Aquaphoton-Training-25/mega-project-team-1/README.md

Review Assignment Due Date (https://classroom.github.com/a/V6TR939q)

# **the final report (technical report) is in the non technical tasks directory**
