Aquaphoton-Training-25/mega-project-team-1/Firmware/README.md

# - **You will find the mcu code in the finalmegaproject directory**   
# - **The blueetooth code is in the communication directory**
# - **The circuit trial md file have a screen shot for the first connection we made in tincker cad**
