Aquaphoton-Training-25/mega-project-team-1/Non-Technical Tasks/Daily reports/Day 8.md

# Day 8 Report
## Hardware Progression
- Fabricated the PCB. --> Soad, Ibrahim and Mazen

## Firmware Progression
- Modified the some Firmware code. --> Ibrahim and Mazen
- Tried to fix some issues with the sensors reading.  --> Mazen

## Software Progression
- Finished integrating the Stereo Vision in the GUI. --> Abdullah
- Removed some bugs and imporved performance of the App. --> Abdullah
- Integrated most of the Firmware in the GUI. --> Malak
- Started working on the Technical report. --> Malak
