Aquaphoton-Training-25/mega-project-team-1/Non-Technical Tasks/Daily reports/Day 7 Report.md

# Day 7 Report
## Hardware progression
- Finished the PCB design of the microcontroller circuit.
- Finished with the PCB design of the indicator and sensor circuit.
- Working on the printed output of the two circuits
- Working on the sticker output of the two circuits
- Working on the report
## Firmware Progression
- Adjusting microcontroller code
- Finalizing bluetooth connection file(python code).
## Software progression
- worked on the integration of the stereo vision in the gui 
- modified the gui to give it the final look
