Aquaphoton-Training-25/mega-project-team-1/Non-Technical Tasks/Daily reports/Day 6 Report.md

# Day 6 Report
## Hardware progression
- Done with the indicators and sensors schematic
- Done a schematic of the motor driver module(will be put aside until taken last decision )
- Done a general check for all schematics logic and connection (some changes have been made ) 
- Started working on the project report
## Firmware Progression
- Connected the circuit on a bread board to ensure functionality.
- Edited the arduino code.
- Started writing the python code which connects the arduino to the GUI.
## Software progression
-  Integrated the video stitching in the GUI
- Finished the camera feed and screenshot backend
- Removed bugs , increased the thread safety, and improved the app performance
