Aquaphoton-Training-25/mega-project-team-1/Firmware/circuit trial.md

# circuit trial

This screen shot is  a trial circuit but its not complete because there is no sensors and bluetooth modules in tincker cad.
