Aquaphoton-Training-25/mega-project-team-1/Non-Technical Tasks/Final Report/Final Report.pdf

# FINAL REPORT

Mazen Aboubakr
Soad Emad
Malak el Moazen
Abdallah Taman
Ibrahim Elshami

### 1. Hardware

### 1.1 Microcontroller circuit

Schematic:
The circuit was made by using the atmega328p-u microcontroller to mimic a circuit so close to the Arduino Uno on
1.ATmega328p and its connection:
1) PC6 (pin 1) I/O pin used as the RESET pin connected to:
- hardware reset, When the voltage on this pin drops to a low level (typically below a certain threshold), the microcontroller resets restarting its program execution.
- Pull-up resistance (R1) is connected between the RESET pin (PC6) and the +5V, This resistor keeps the pin at a high voltage level when no reset signal is applied, preventing accidental resets, and the electrolytic polarized capacitor connected with the reset button 7805 to minimize debouncing problems
2) PD0 (pin 2) is connected to the pin 0 in an 8-pin header pack
3) PD1 (pin 3) is connected to the pin 1 in an 8-pin header pack
4) PD2 (pin 4) is connected to the pin 2 in an 8-pin header pack
5) PD3 (pin 5) is connected to the pin 3 in an 8-pin header pack
6) PD4 (pin 6) is connected to the pin 4 in an 8-pin header pack
7) PD5 (pin 11) is connected to the pin 5 in an 8-pin header pack
8) PD6 (pin 12) is connected to the pin 6 in an 8-pin header pack
9) PD7 (pin 13) is connected to the pin 7 in an 8-pin header pack
- 2) to 9) all have the same use in our schematic which is a general-purpose digital input/output pin. It can be configured as an input or output through software, and its state can be read or set using the appropriate I/O registers.
10) VCC (pin 7) connected directly to the +5v output of the linear regulator 7805 to power the whole microcontroller circuit
11) GND (pin 8,22) connected directly to the common ground between the battery and regulator
12) PB6 (pin 9) is connected to
- One side from the crystal oscillator provides the clock for the microcontroller, PB6 serves as the input for the oscillator signal
- A ceramic capacitor(C4) to stabilize the crystal's oscillation frequency and form a resonant circuit with the crystal. This resonance ensures that the oscillation amplitude is consistent

13) PB7 (pin 10) is connected to
- The other side from the crystal oscillator provides the clock for the microcontroller, PB6 serves as the output for the oscillator signal
- A ceramic capacitor(C5) to stabilize the crystal's oscillation frequency and form a resonant circuit with the crystal. This resonance ensures that the oscillation amplitude is consistent
14) PB0 (pin 14) is connected to the pin 8 in a 10-pin header pack
15) PB1 (pin 15) is connected to the pin 9 in a 10-pin header pack
16) PB2 (pin 16) is connected to the pin 10 in a 10-pin header pack
17) PB3 (pin 17) is connected to the pin 11 in a 10-pin header pack
18) PB4 (pin 18) is connected to the pin 12 in a 10-pin header pack
19) PB5 (pin 19) is connected to
- the pin 13 in a 10-pin header pack
- a LED (D1) with its limiting resistance (R2) to test the functionality of the microcontroller in the circuit (BUILT-IN LED)
- 2) to 9) all have the same use in our schematic which is working as an 8-bit bi-directional I/O port with internal pull-up resistors (selected for each bit). It can be configured as an input or output through software, and its state can be read or set using the appropriate I/O registers
20) AVCC (pin 20) is sensitive to power fluctuations which is crucial for providing power to the analog-to-digital converter (ADC) and some of the analog circuitry
- to the +5v output of the linear regulator 7805 ensures a stable supply.
- a polarized electrolytic capacitor(C1) which is connected directly to GND which is essential for filtering out any noise or voltage fluctuations in the power supply
21) AREF (pin21) is used to provide a reference voltage for the analog-to-digital converter (ADC), the technique used in our project to power it is to connect it with an external +5 volt by using a jumper from the Arduino UNO
22) PC0 (pin 23) is connected to the pin A0 in a 6-pin header pack
23) PC1 (pin 24) is connected to the pin A1 in a 6-pin header pack
24) PC2 (pin 25) is connected to the pin A2 in a 6-pin header pack
25) PC3 (pin 26) is connected to the pin A3 in a 6-pin header pack
26) PC4 (pin 27) is connected to
- the pin A4 in a 6-pin header pack
- the pin SDA in a 10-pin header pack to serve as the SDA line for I²C communication
27) PC5 (pin 28) is connected to
- the pin A5 in a 6-pin header pack
- the pin SCL in a 10-pin header pack which is used for clocking data on the I²C bus. It works in conjunction with the SDA pin (PC4)

- 22) to 27) all have the same use in our schematic which is a 7-bit bi-directional ANALOG I/O port with internal pull-up resistors. It can be configured as an input or output through software, and its state can be read or set using the appropriate I/O registers

### 2. linear regulator 7805:

- powering the whole circuit of the microcontroller and the other external components that will be attached
- protection for the microcontroller as it stables the high voltage coming from the power supply, battery, and adaptor to a +5 voltage which is the maximum safest option for atmega328-p

### 3. battery terminal: to attach the battery or the adaptor to it

### 4. pin headers: To interface and connect with external components

5. ceramic capacitors: which are placed close to GND or VCC to work as decoupling capacitors to:
- filter out high-frequency noise from the power supply, which could otherwise interfere with the proper operation of the circuit
- stabilize the voltage supply by compensating for sudden drops or spikes in power consumption
- reduce electromagnetic interference (EMI) in the circuit by providing a short path to ground for high-frequency signals

### 6. electrolytic polarized capacitors:

- C1: filtering out any noise or voltage fluctuations in the power supply
- C2: minimize debouncing problem coming from the push button

### 7. crystal oscillator:

- generates a stable clock signal that dictates the speed at which the microcontroller executes instructions. This clock frequency directly affects the timing of all operations, including loops, delays, and communication protocols.

### 8. led: to indicate that the circuit is working

### 9. resistance:

- R1: pullup resistance to keep the point at high voltage (not floating)
- R2: limiting current resistance to protect the diode

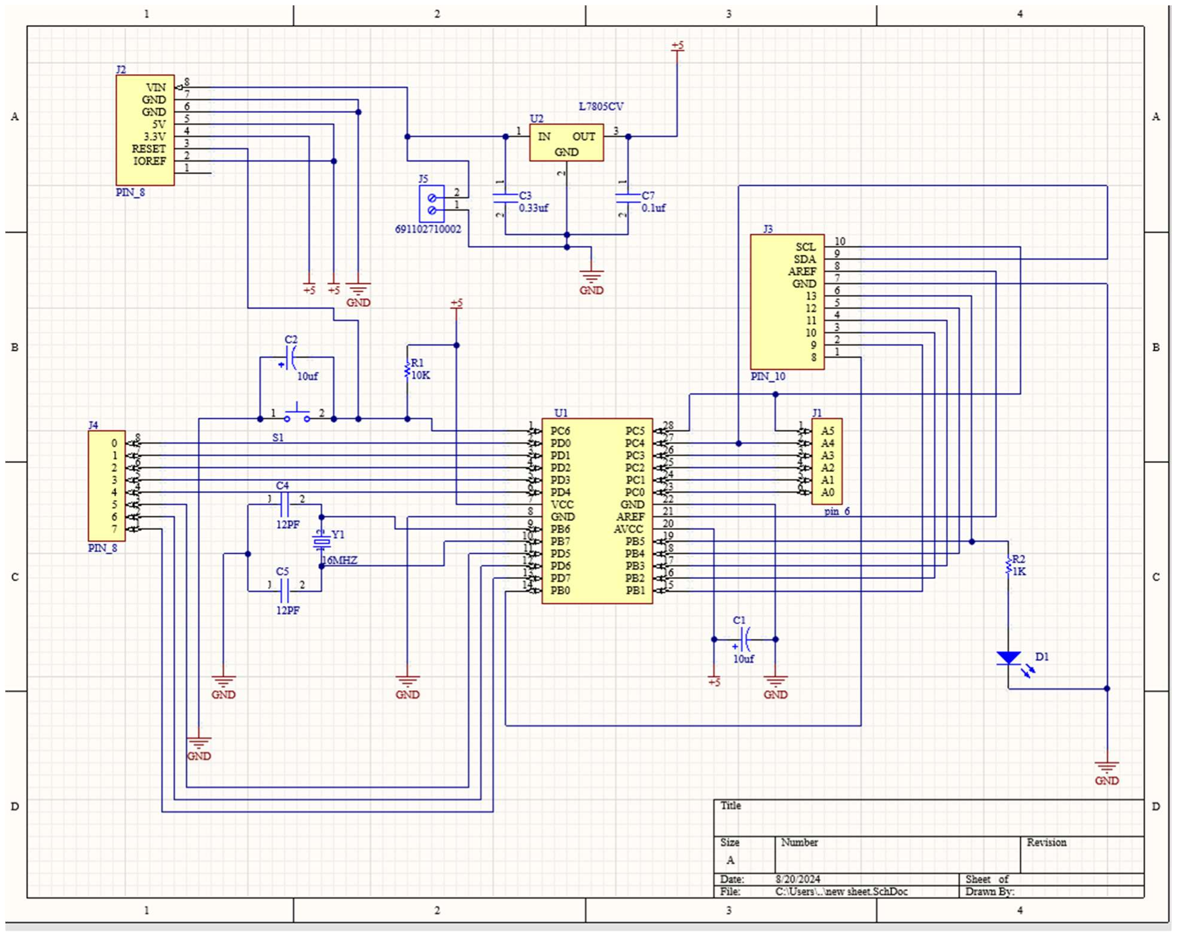
[picture p1: figure]

### 2. PCB layout and design:

The components were placed according to the logic, standards, rules, routing ability
- Battery terminal and regulator placed close together on the high left of the PCB board
- Pin-headers and other components were placed according to the shortest, most untangled path with the atmega328p
Number of layers: one layer (top)
Minimum clearance: 0.5mm
Average clearance: 0.5mm
Routing width (max, min, preferred): 0.8mm
Routing: was done automatically with manual checks and edits Design rules: was checked and made sure all are logical

Dimensions: 12.2cm *17.8cm

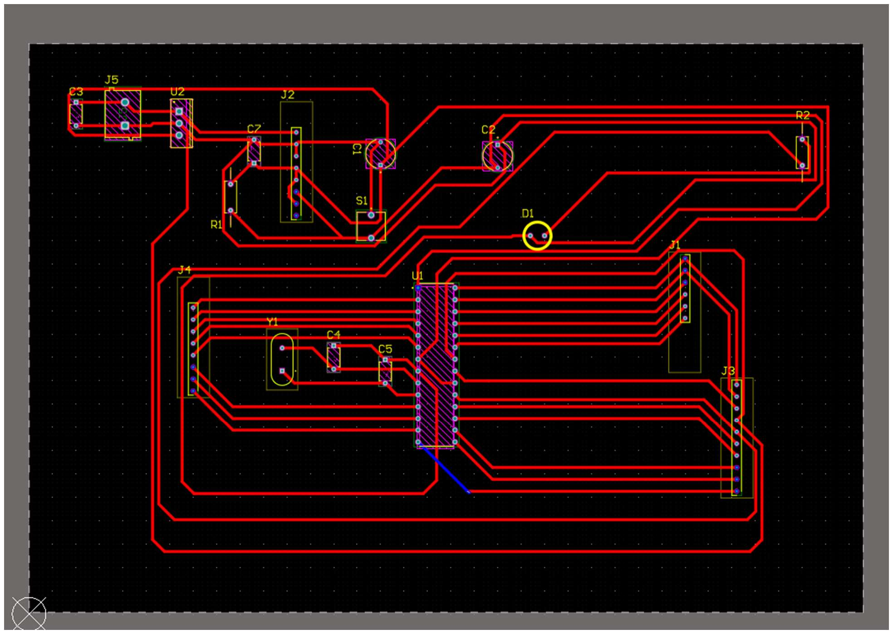
[picture p2: figure]

### 3. symbols and footprint:

According to the datasheet and real-life measured components:
- Some were made manually and
- others were downloaded and imported from specific electronic websites (mouser, snapeda, etc), and then the required edits were made upon them

Indicators and sensors circuit
1.schematic:

### 1. voltage divider:

were made internally in the circuit (not as a separate module) by using two resistances R4 and R5, the values for resistances allow a maximum voltage read of 28.5
R4 is a 1k ohm resistance attached to:
- Node common between measured ground and Arduino ground
- The sensing point which is a pin (I-sens) that would be connected to the analog pin on the Arduino
R5 is a 4.7k ohm resistance attached to:
- Sensing point
- A pin that will be connected to the measured voltage

### 2. LEDs (D1, D3, D4):

Indicators for different aspects of the circuit

### 3. RGB LED(D1):

Indicator for the speed, where each color pin is connected with a pin from a 10-pin header pack that will be connected to the pin-headers of the microcontroller, GND will be connected to the GND from the microcontroller circuit

### 4. Resistances (except the voltage divider ones):

They are current limiting resistance to protect the indicator LEDs, their values were put according to the datasheet

### 5. Linear regulator 7805:

Ensure that the voltage coming from the mc or going to it is a +5v

### 6. Ceramic capacitors (C1, C2):

Decoupling capacitor for filtration

### 7. Pin-headers (J1, J2):

### 2 sets of 10-pack pin headers are used for

- Connection for interfacing with microcontroller pins
- Additional ground and power pins for other external components

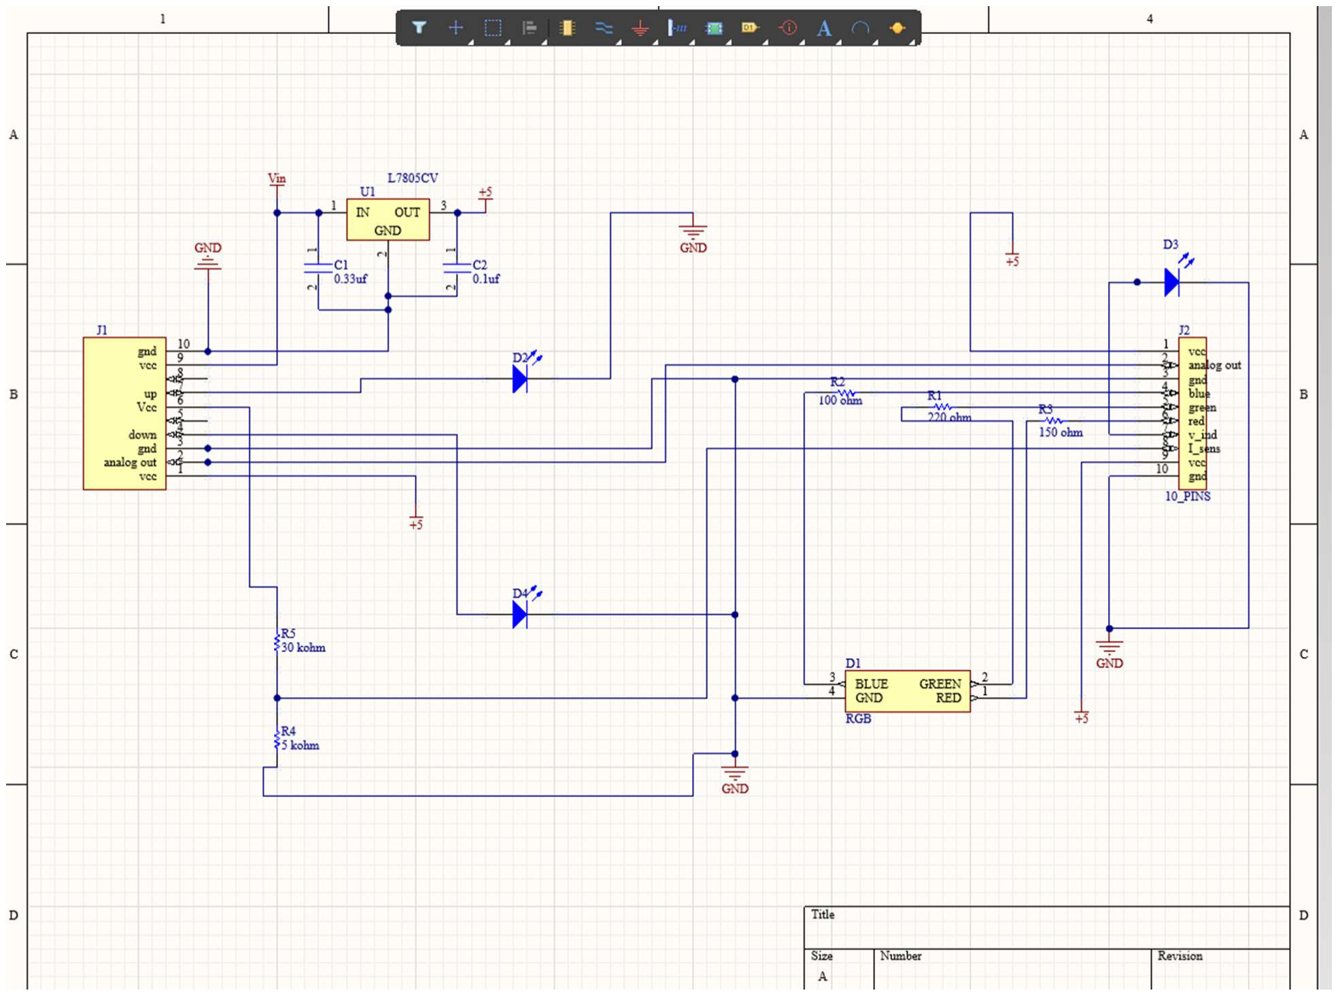
[picture p3: figure]

### 2. PCB layout and design:

The components were placed according to the logic, standards, rules, routing ability
- Battery terminal and regulator placed close together on the high left of the PCB board
- Pin-headers and other components were placed according to the shortest, most untangled paths
Number of layers: one layer (top)
Minimum clearance: 0.7mm
Average clearance: 0.7mm
Routing width (max, min, preferred): 0.8mm
Routing: was done automatically with manual checks and edits Design rules: was checked and made sure all are logical Dimensions: 8.5cm *6.5cm

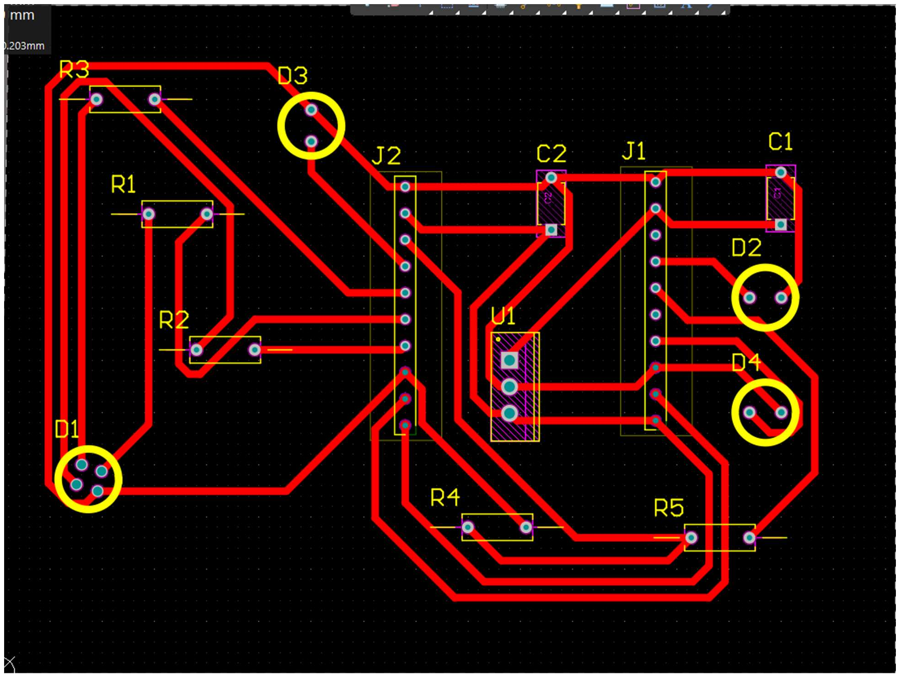
[picture p4: figure]

### 3. symbols and footprint:

According to the datasheet and real-life measured components:
- Some were made manually
- others were downloaded and imported from specific electronic websites (mouser, snapeda, etc), and then the required edits were made upon them

### 2. Firmware 2.1 Arduino code

The code starts with declaring all constant values needed using #define to reduce usage of memory as possible and to hold the pin numbers of each component, the constants are distributed as following 3 constants for each motor 2 if them to specify the motor’s direction and the third constant to specify its speed, 2 constants for the trigger and echo pin of the ultrasonic sensor ,3 constants for the RGB led one for each color and two constants for the current and voltage sensors.

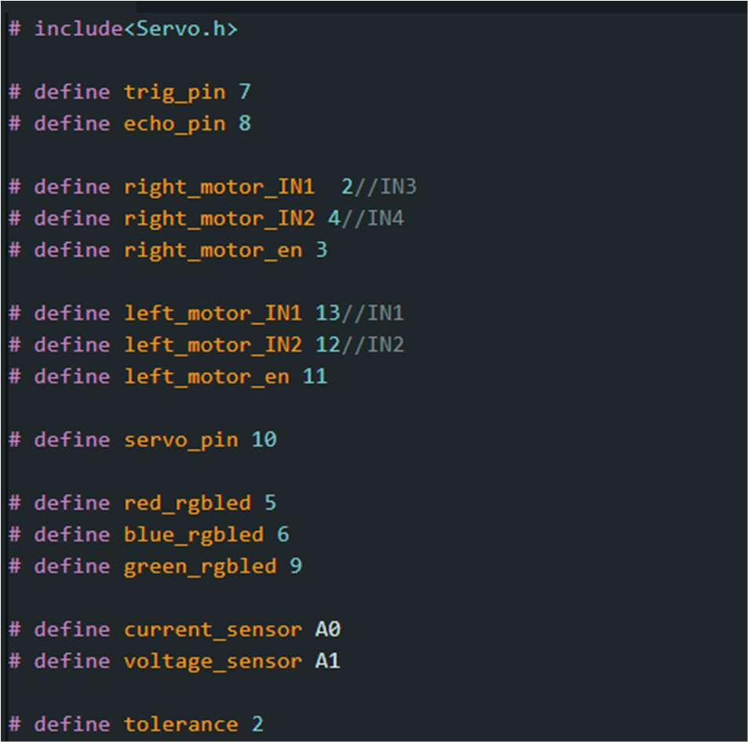
[picture p5: figure]

The code then proceeds to declaring all variables with the needed datatypes.

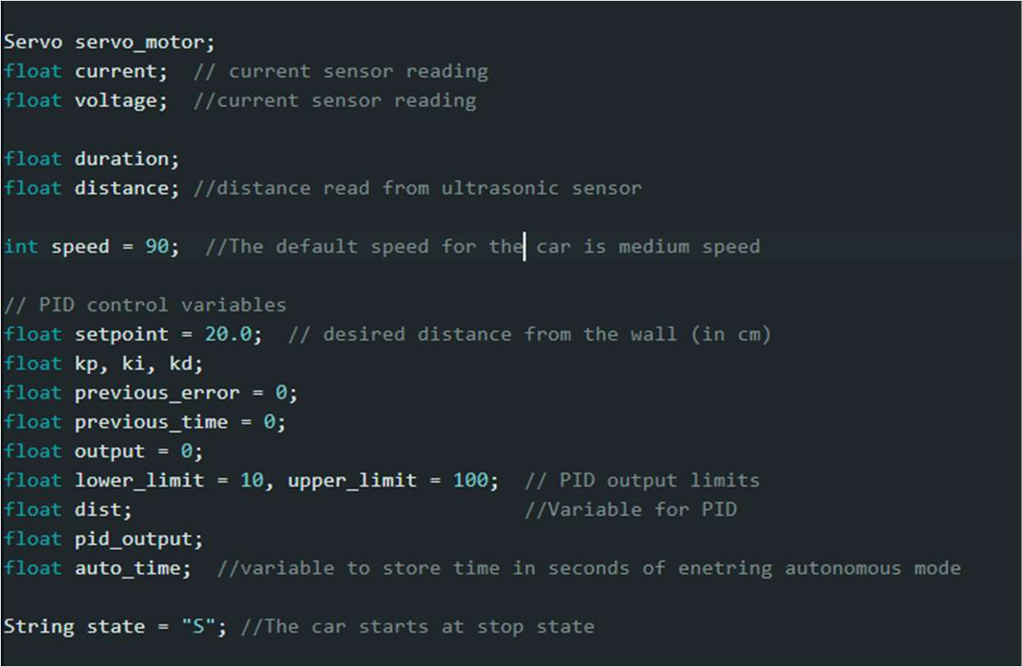
[picture p6: figure]

In the setup all commands that need to be made once are called as assigning INPUT/OUTPUT modes for each pin to serve its purpose and starting Serial connection to allow communication between microcontroller and the GUI user

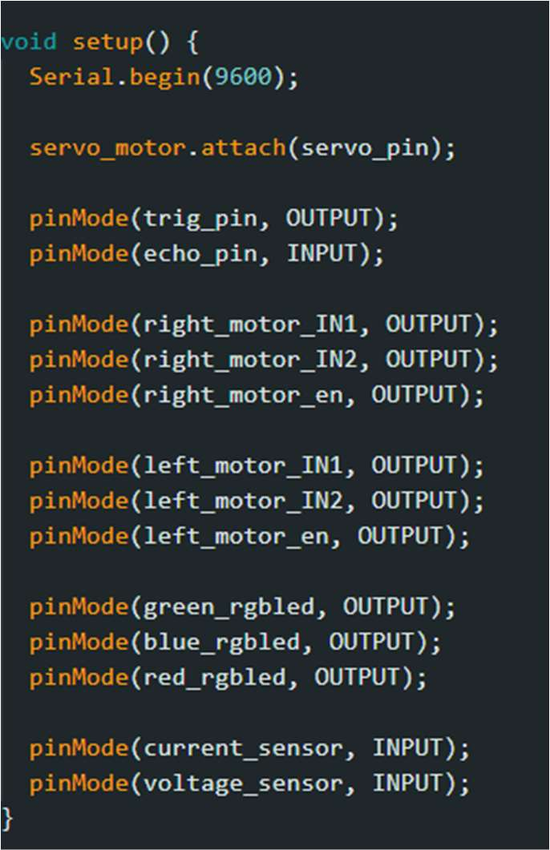
[picture p7: figure]

In order to understand the role of the loop function, we should first know other fundamental functions work.
The process_command function which is called
each time any commands are given by the user,
the process _command function uses a series of if-else statements to map the commands received to the corresponding functions to be called.

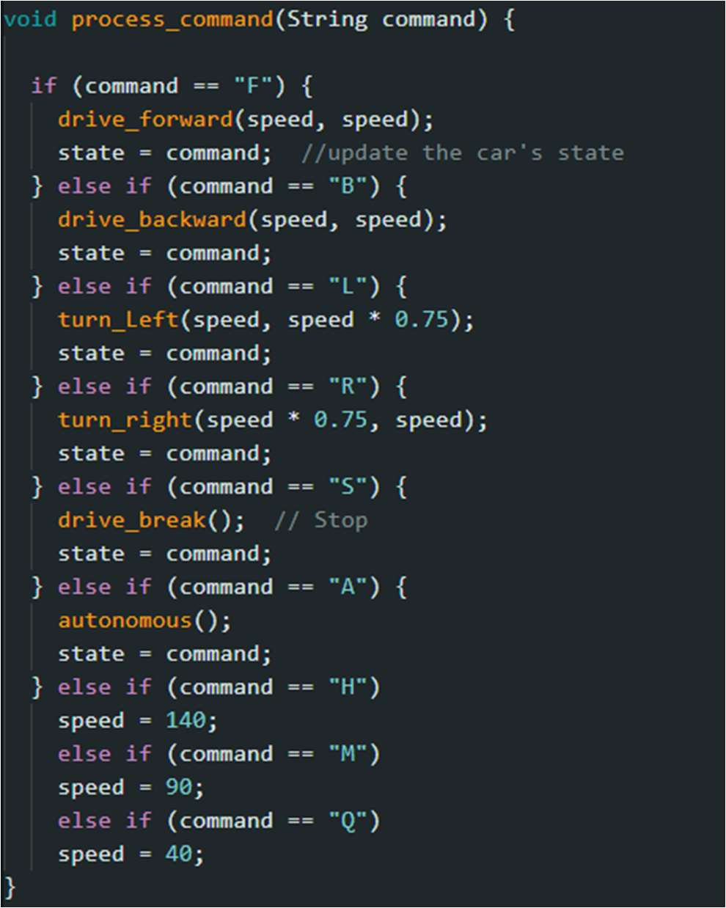
[picture p8: figure]

The read distance function gets the ultrasonic reading which ranges from 2cm to 400 cm when called, this function is used later in find_wall function which is used to find the nearest wall and its distance in autonomus mode by using a servo to mount the ultrasonic sensor, the servo is set to be on the a side, then the distance to the wall is received then the servo moves the sensor to the other side and the distance to the second wall is stored, then the two reading are compared and the servo rotates to the nearest wall side and the car moves parallel to it

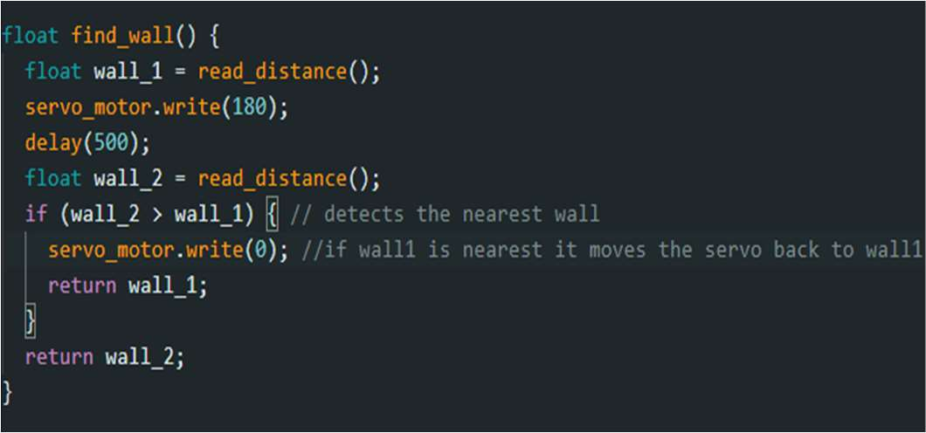
[picture p9: figure]
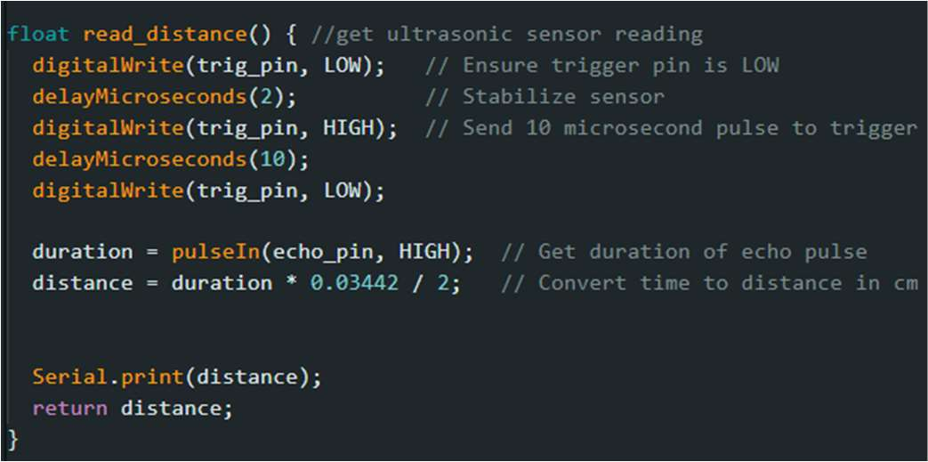
[picture p10: figure]

The read_current function reads the voltage on the current_sensor pin and applies it to a reversed equation to calculate the current reading. The equation: current= (voltage-2.5)/0.185 according to the ACS712 5A.
The read_voltage function reads the voltage on the voltage_sensor pin which is the voltage on a 1 kilo ohm which is connected in series to a 4.7 kilo ohm so by applying a reverse voltage divider we can get a voltage range of 0-28.5 volts, the voltage is found by applying the following equation Voltage = (1k ohm resistance voltage*(1k ohm+4.7k ohm)/1k ohm.

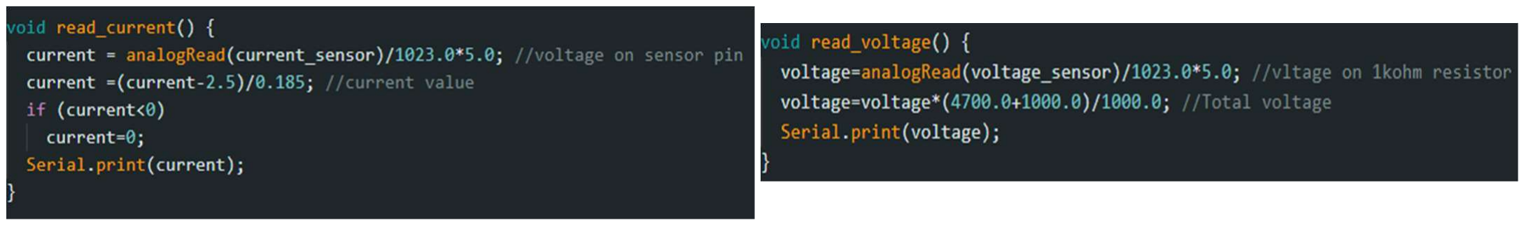
[picture p11: figure]

The send_readings function calls the 3 sensors functions ,read_voltage(), read_current(), read_distance(), sends their readings divided by a colon and then send the car state and prints a newline character ‘\n’ to ensure data has a consistent format to be easily received on the user’s end.

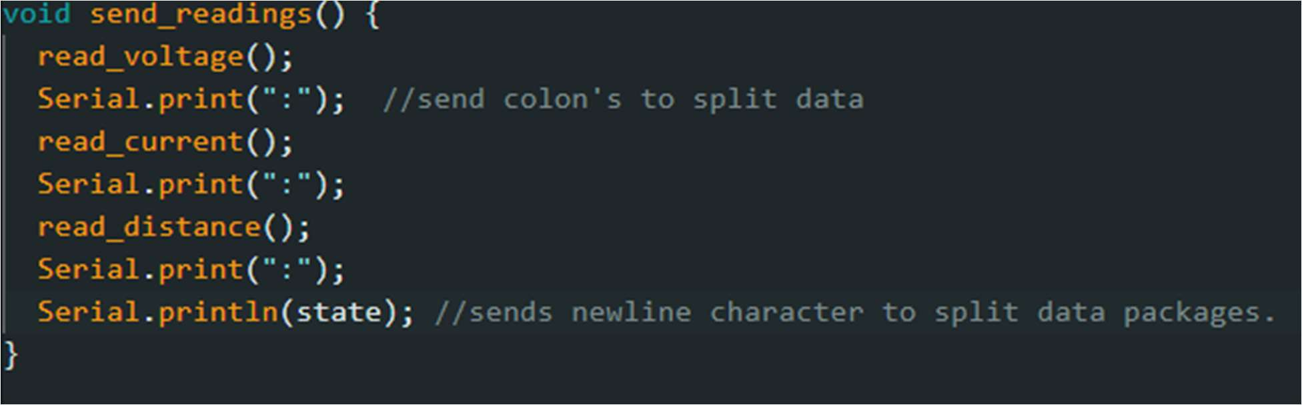
[picture p12: figure]
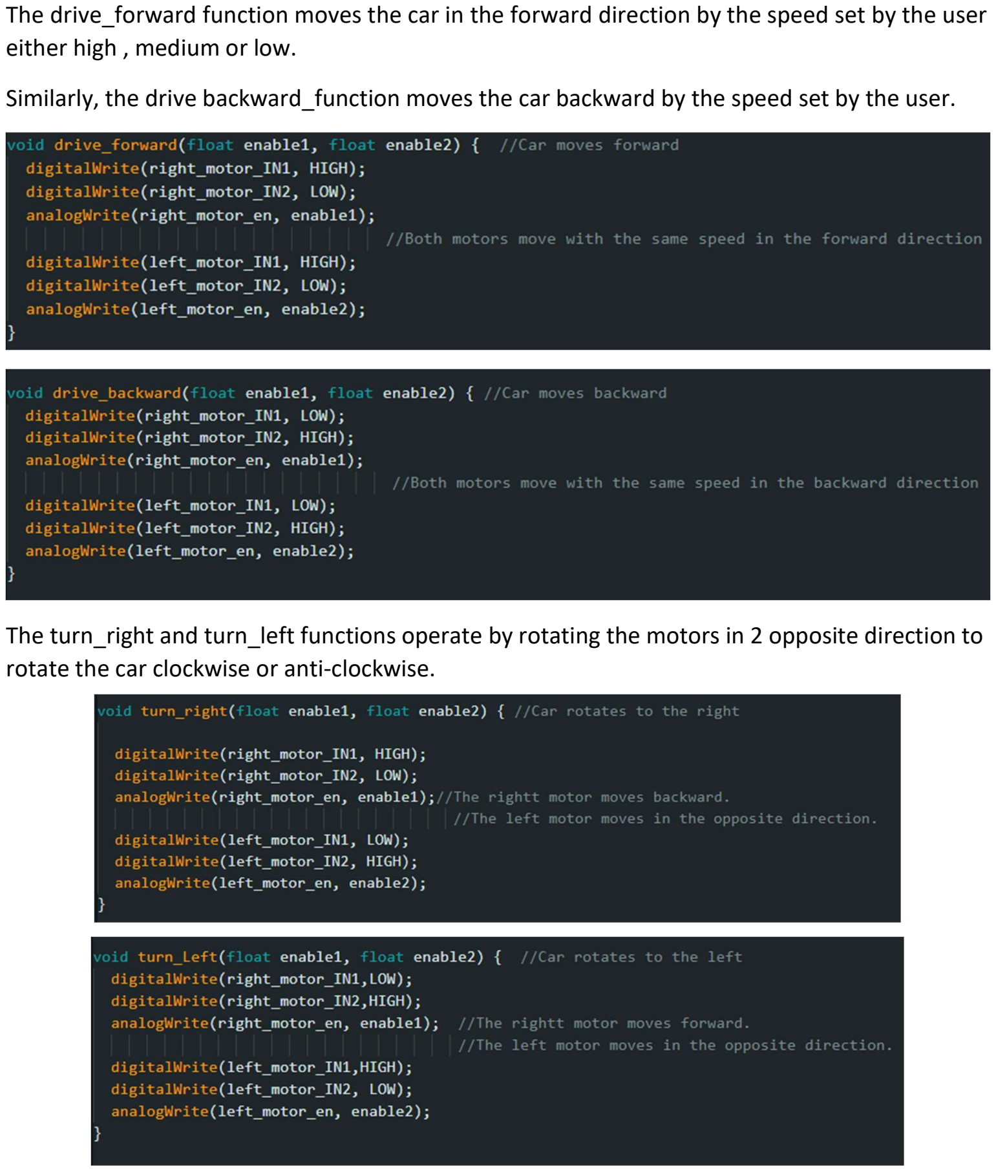
[picture p13: page 13]

The drive_forward function moves the car in the forward direction by the speed set by the user either high , medium or low.
Similarly, the drive backward_function moves the car backward by the speed set by the user.

The turn_right and turn_left functions operate by rotating the motors in 2 opposite direction to rotate the car clockwise or anti-clockwise.

The last motion related function is the drive_break function which stops rotation of the motors, it is also used to exit autonomous mode and enter manual mode.

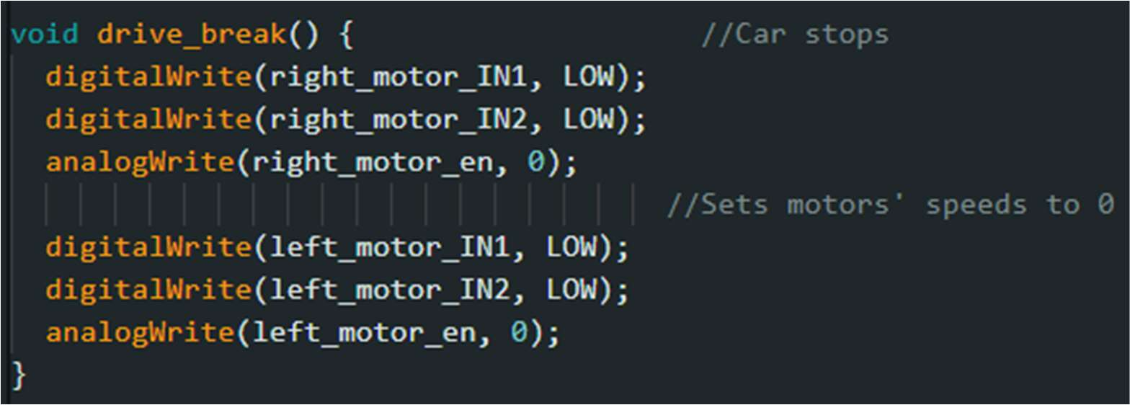
[picture p14: figure]

The compute_output function is for the calculation of the PID equation that takes the feedback from the ultrasonic sensor to calculate the error between the desired distance and the current distance from the wall then it calculate the PID equation that consist of three terms:

### 1. proportional term: the multiply of proportional gain (Kp)and the error

2. integral term: the multiply of integral gain(Ki) , error and the delta time.
3. derivative term: division of error to the change in time then multiply to the derivative gain (Kd).
After it calculates the output It calls the map_to_limits_function to set the limits as we explained in the documentation of the map_to_limits_function, then it returns the last output.

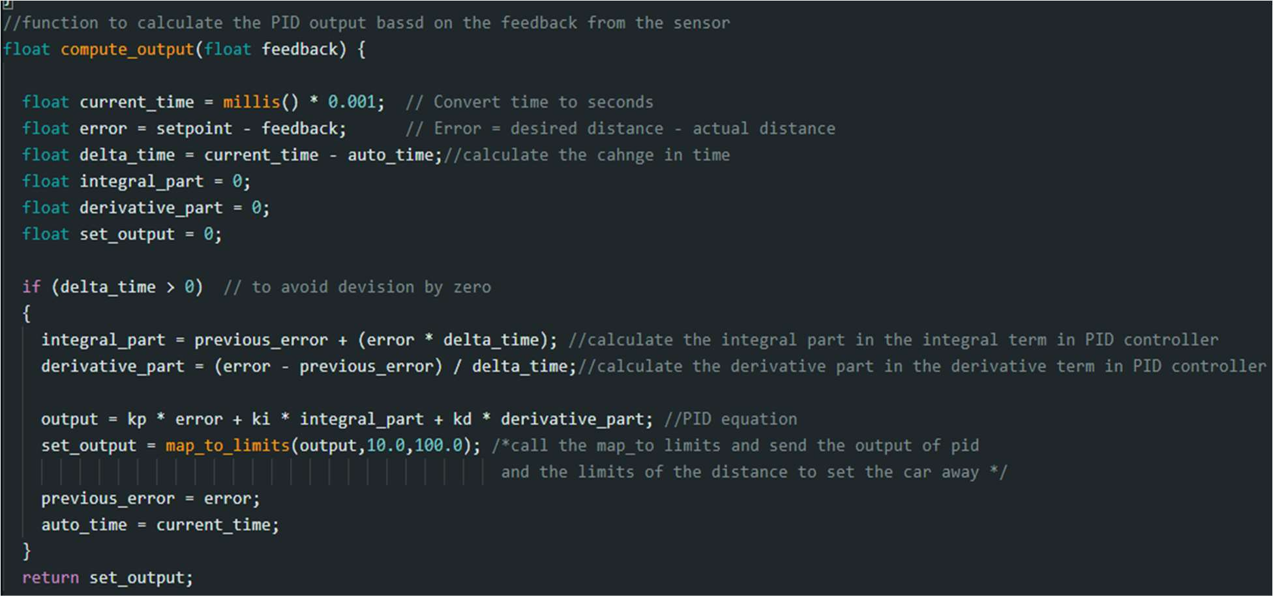
[picture p15: figure]

The map_to_limits function is used to set limits to the output of the PID controller to ensure that it is in the range that we want and it takes three variables, the lower limit and the upper limit for the range and the value of the output of the PID

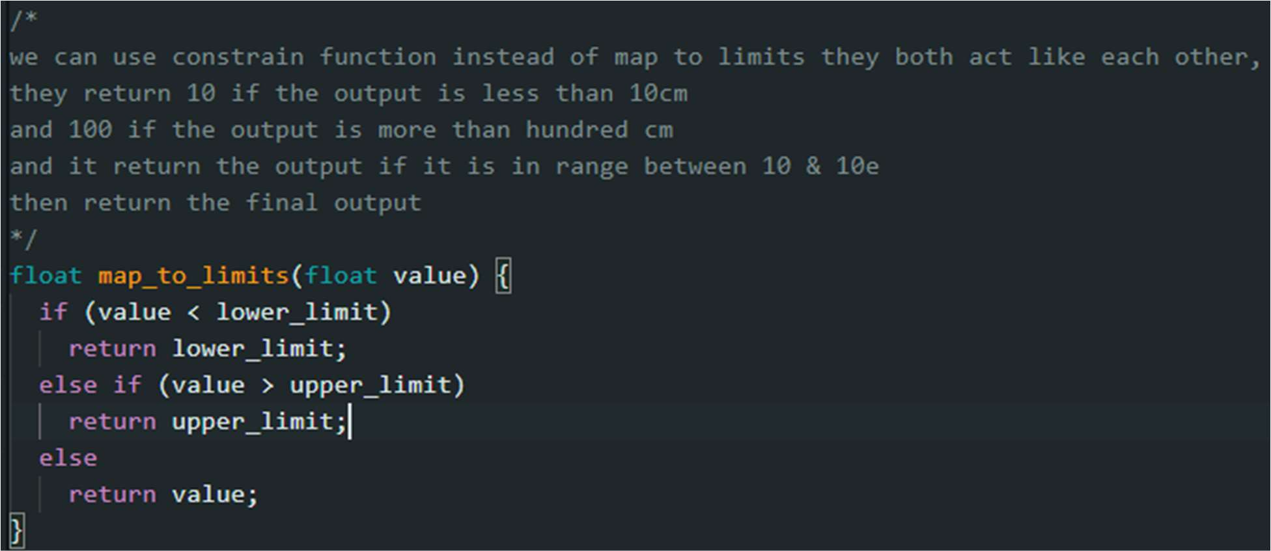
[picture p16: figure]

The control_motors function is used to get the output of the PId then use it to control the sped of the two motors to turn right or left, to make the car move parallel to the wall from a fixed distance and the if condition in it is to detect if the difference between the desired distance and the current distance is less than the tolerance of the sensor that is set to 2 as we try to read the distance from the ultrasonic sensor in tinckercad and we found that after we adjust the speed of sound to be 0.3442 and we reached a small error in the read . Then it sees if the difference is less than the tolerance it will make the motor move forward and parallel to the wall If not it will make the car turn right or left to reach the desired distance.

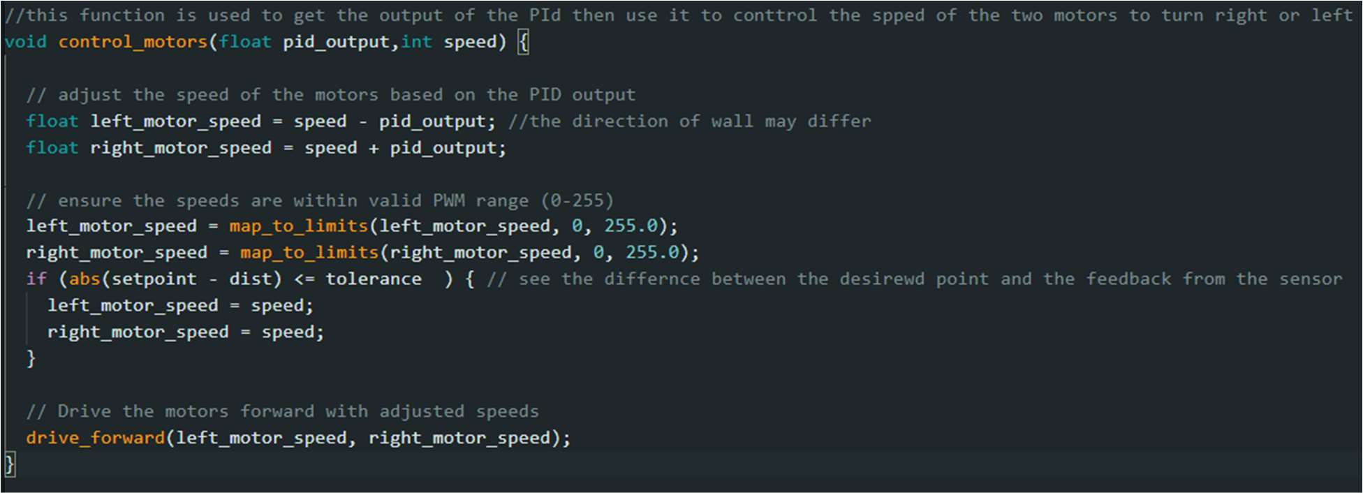
[picture p17: figure]

The autonomous function function is used when we click the autonomous mode in the GUI, it first sets the servo direction to the nearest wall using find_wall function and returns the distance between this wall and the car then it will see if it gets the Stop command it will break and exit the function if not it will compute the feedback and control the motors to move parallel to the wall.

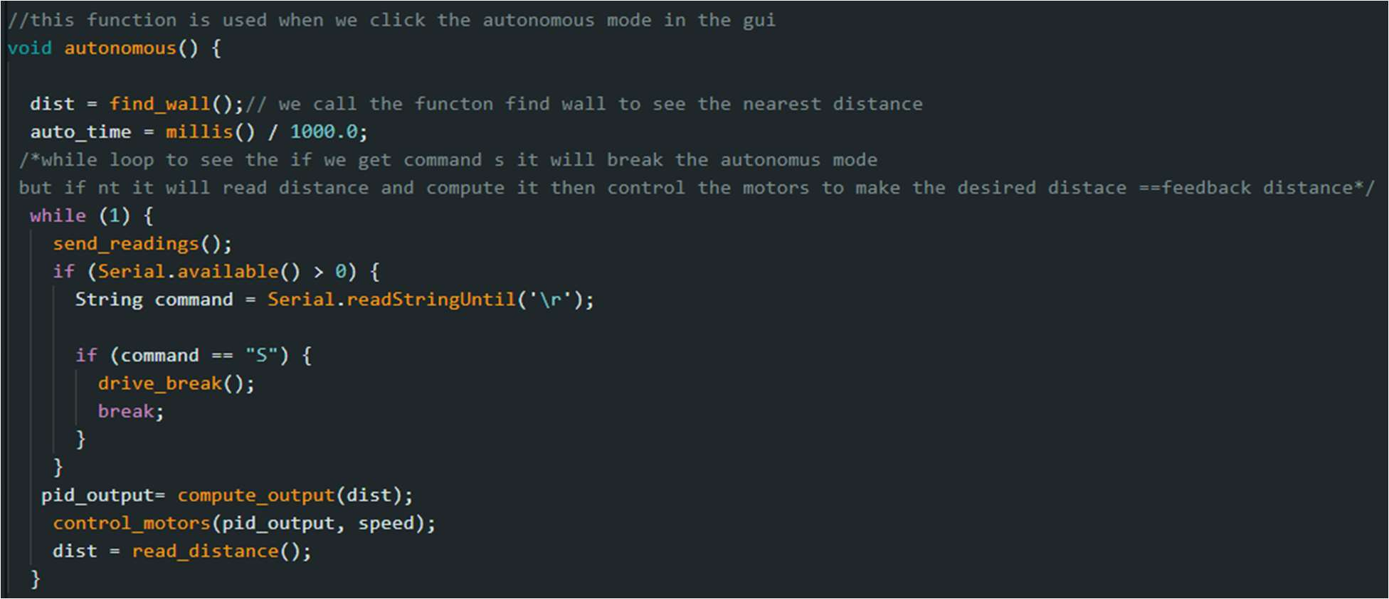
[picture p18: figure]

After understanding the fundamental functions we can understand the loop function role which is the key to switching the car’s modes and states were the user’s commands are read in it and processed using process_command function by calling the required functions and the loop function ends by send_readings function to ensure updated data are always available for the user.

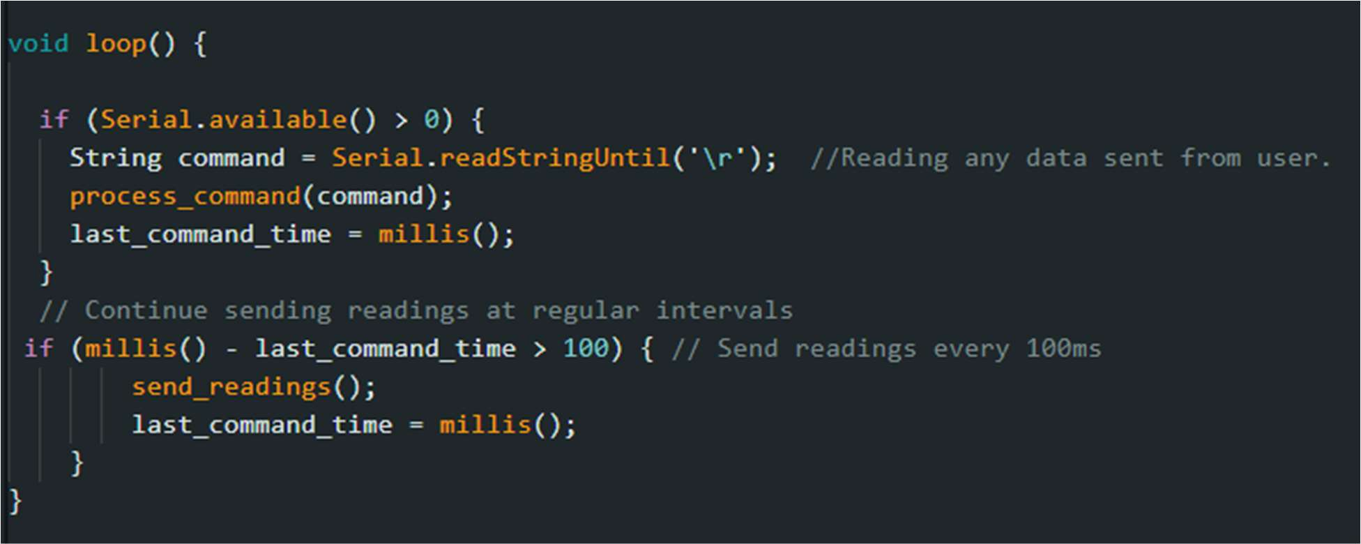
[picture p19: figure]

### 2.1 Python code

The python uses Pyserial library to allow communication between the microcontroller and the GIU over Bluetooth.
The code begins with improting the Pyserial library and time library which is used to add delays in the code to allow initialization of connection.
The first event that occurs is creating an instance of Serial class giving it the necessary arguments which are the COM port of the Bluetooth and the baudrate which is the number of bytes sent per second to be compatible with the Bluetooth module.

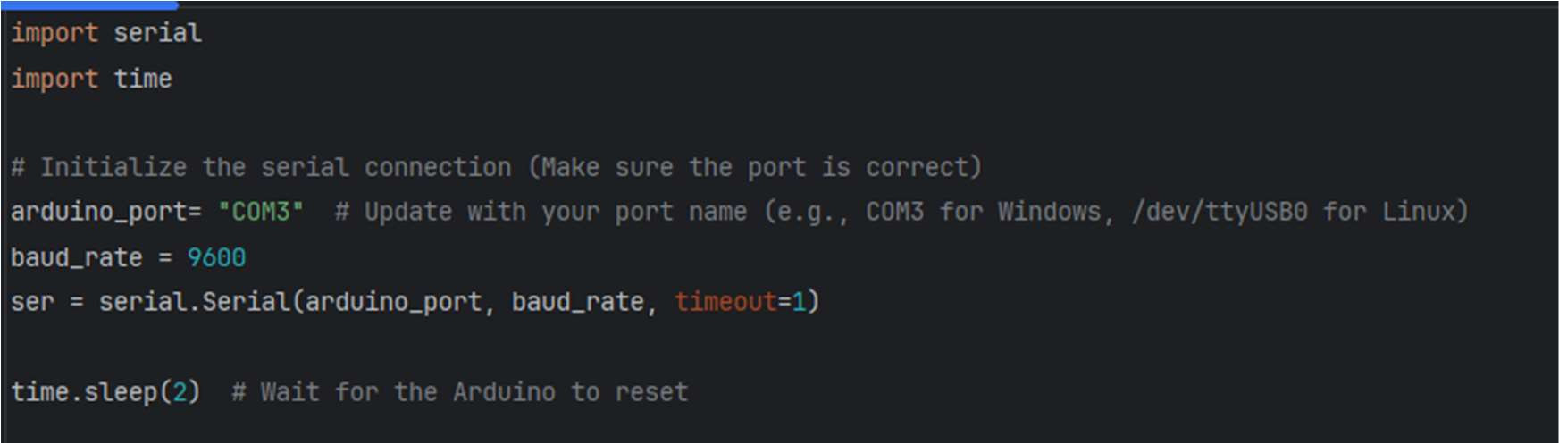
[picture p20: figure]

The code contains 2 main functions which are send_command and the receive_command.
The send_command function receives one argument which is the command letter and and adds a carriage return character which is used to prevent conflict of commands then decodes the command and transmits it

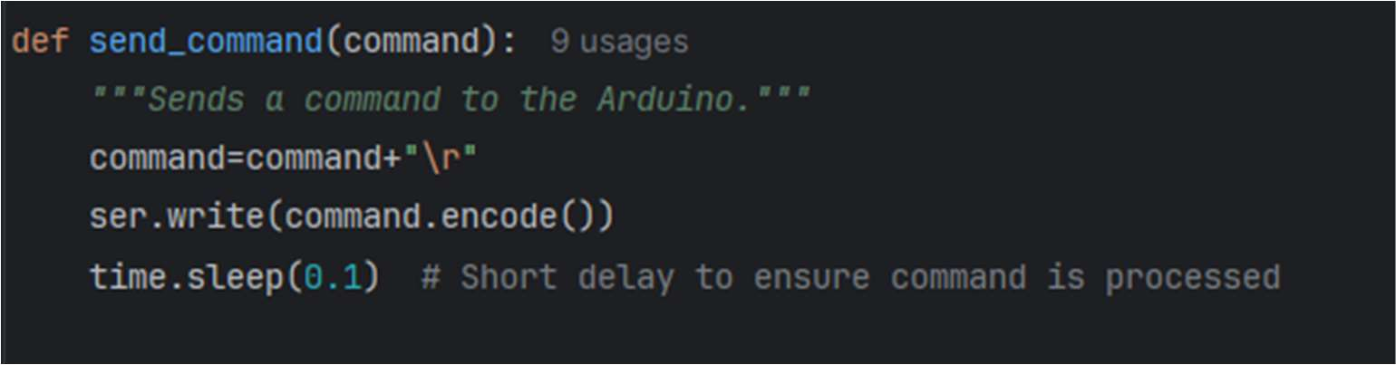
[picture p21: figure]

The receive_data function is used to check if any reading are sent from the mc and unpacks the data and adds each reading to its corresponding variable

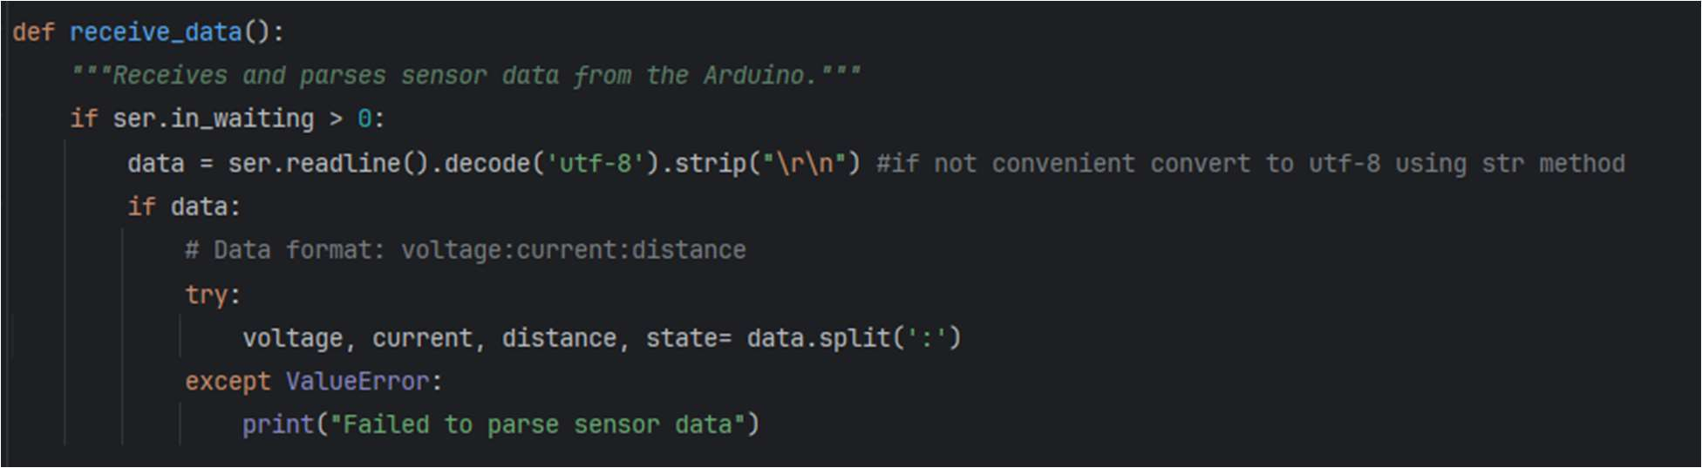
[picture p22: figure]

All other functions are used to provide the unique command character for the needed command

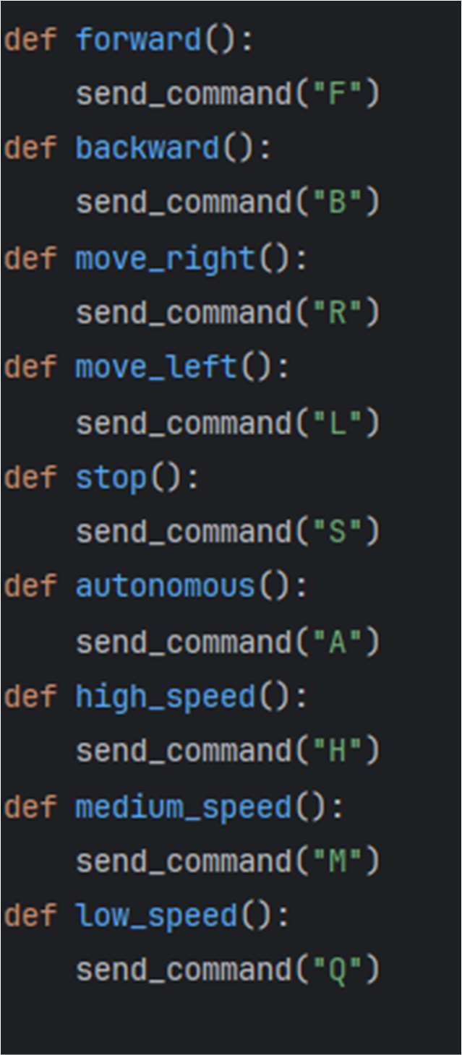
[picture p23: figure]

It is decided not to use this python file (car_control.py) which is uploaded to the repository to avoid an error that prevents access to the mc COM port instead all function are written inside the main GUI file.

3.SOFTWARE

### Computer vision

1-video stitching
The video stitching system integrates video processing and graphical user interface (GUI) components to perform real-time video stitching of left and right video feeds.
We use :
PyQt6 GUI: For user interaction, allowing users to select video files and control stitching operations.
OpenCV: For video processing, including reading video files, stitching frames, and saving the output.
Multithreading: To handle video processing
Algorithm :
- Input: Two video files (left and right views).
- Process: Stitches frames from both videos into a single panoramic view.
- Output: A stitched video file

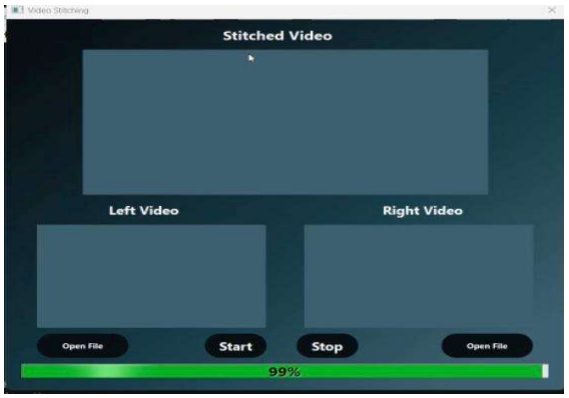
[picture p24: figure]

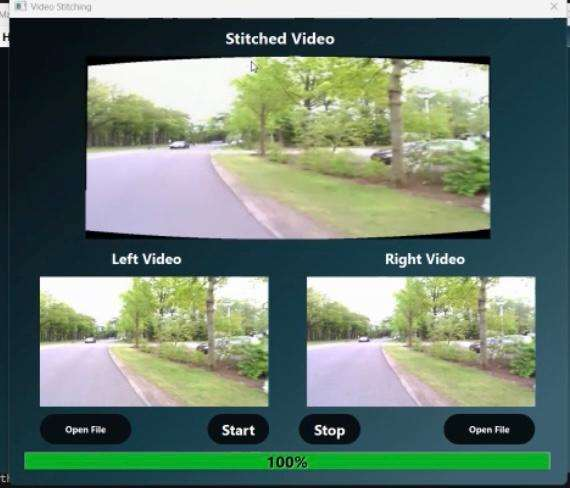
[picture p25: figure]
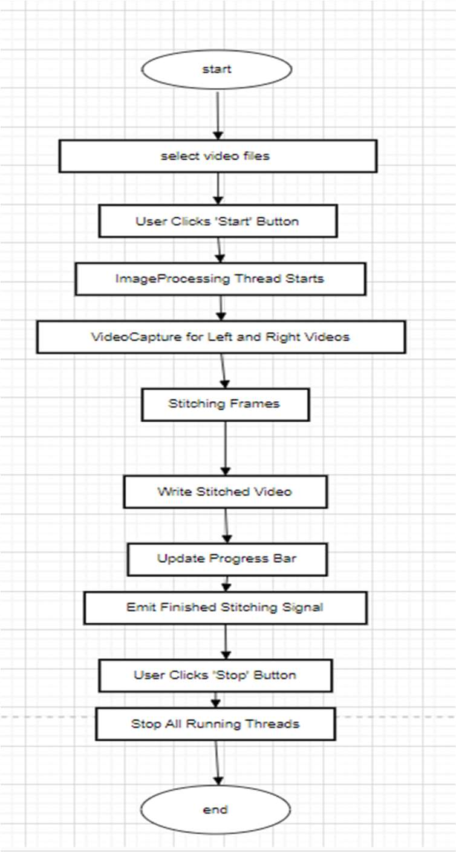
[picture p26: figure]

2-stereo vision
Stereo vision is a technique for inferring the 3D structure of a scene from two images taken from slightly different viewpoints.
We Use:
the SIFT (Scale-Invariant Feature Transform) algorithm to detect keypoints and compute descriptors in both images.We Match features between the two images using the BFMatcher (Brute Force Matcher) with the L2 norm, Filter out outlier matches using the mask returned by the RANSAC process. Initialize the StereoSGBM (Semi-Global Block Matching) algorithm with appropriate parameters, including the number of disparities, block size, and uniqueness ratio. Compute the disparity map using the rectified images. The disparity map represents the pixel difference between corresponding points in the two images. Algorithm :
- Input: Two image files (left and right views), width ,height ,baseline and camera matrices
- Process: Plotting the epipolar lines on both images along with feature points,save the disparity as a gray scale and color image using heat map conversion and save the depth image as a gray scale and color image using heat map conversion.
- Output: in GUI the image will appear and you can know the distance between any 2 points

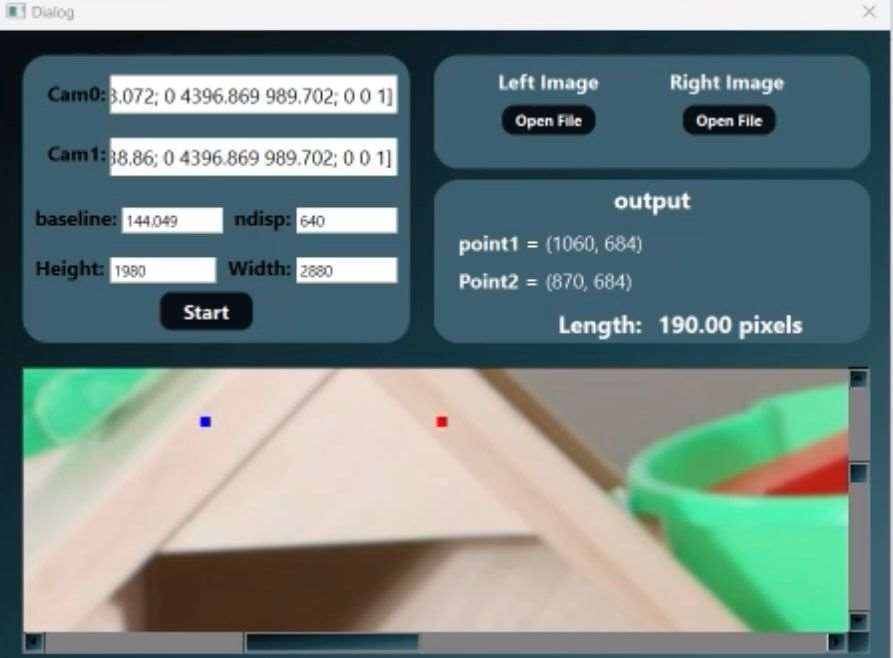
[picture p27: figure]

Flow chart:

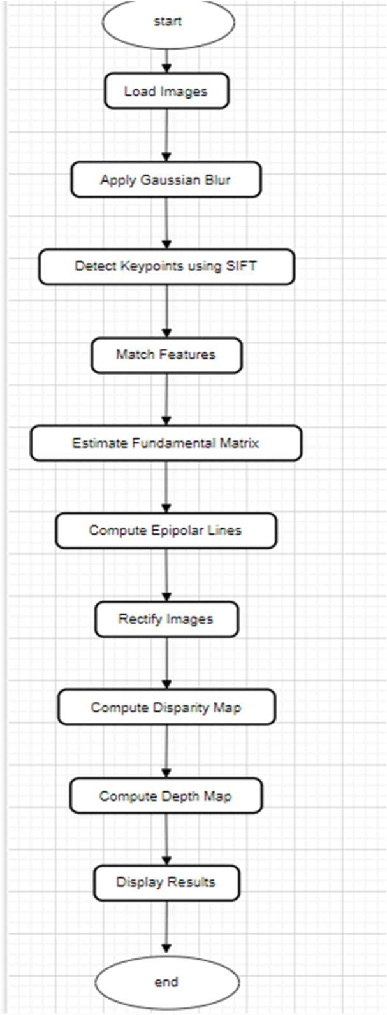
[picture p28: figure]

### GUI:

Mainwindow:
We use tab widget in each window, The GUI features a central QTabWidget with three tabs: Home , Control and camera. Each tab contains styled buttons and labels arranged in frames with rounded corners. The color scheme involves shades of blue with white text.
Home Tab :
includes buttons for "Video Stitching" and "Stereo Vision," and displays the team logo.

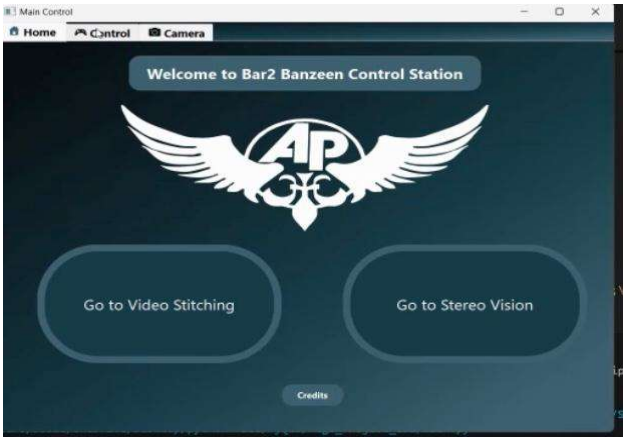
[picture p29: figure]

Control tab :
1.Mode Selection
Autonomous and Manual Mode: allowing the user to choose between autonomous operation (where the system operates independently) and manual operation (where the user has direct control).

### 2. Speed Control

- High, Medium, Low Speed Settings: There are three buttons which likely control the speed of the system. The user can select one of these buttons to adjust the operating speed.

### 3. Controller Selection

- Keyboard and GUI Options: There are two buttons labeled "Keyboard" and "GUI." These allow the user to choose the control method

### 4. Movement Controls

- Directional Control Buttons: There are four directional buttons arranged in a circular pattern, which are used to control the movement of the vehicle . These include buttons for moving forward, backward, left, and right.

### 5. Additional Indicators and Information

- Indicators Panel: This section provides information about various parameters such as voltage, current, speed, mode, distance, direction, connection status, and the type of controller in use. It’s designed to keep the user informed about the status and performance of the system.
- Stop Button: A prominent red button labeled "Stop" is also present to stop the vehicle

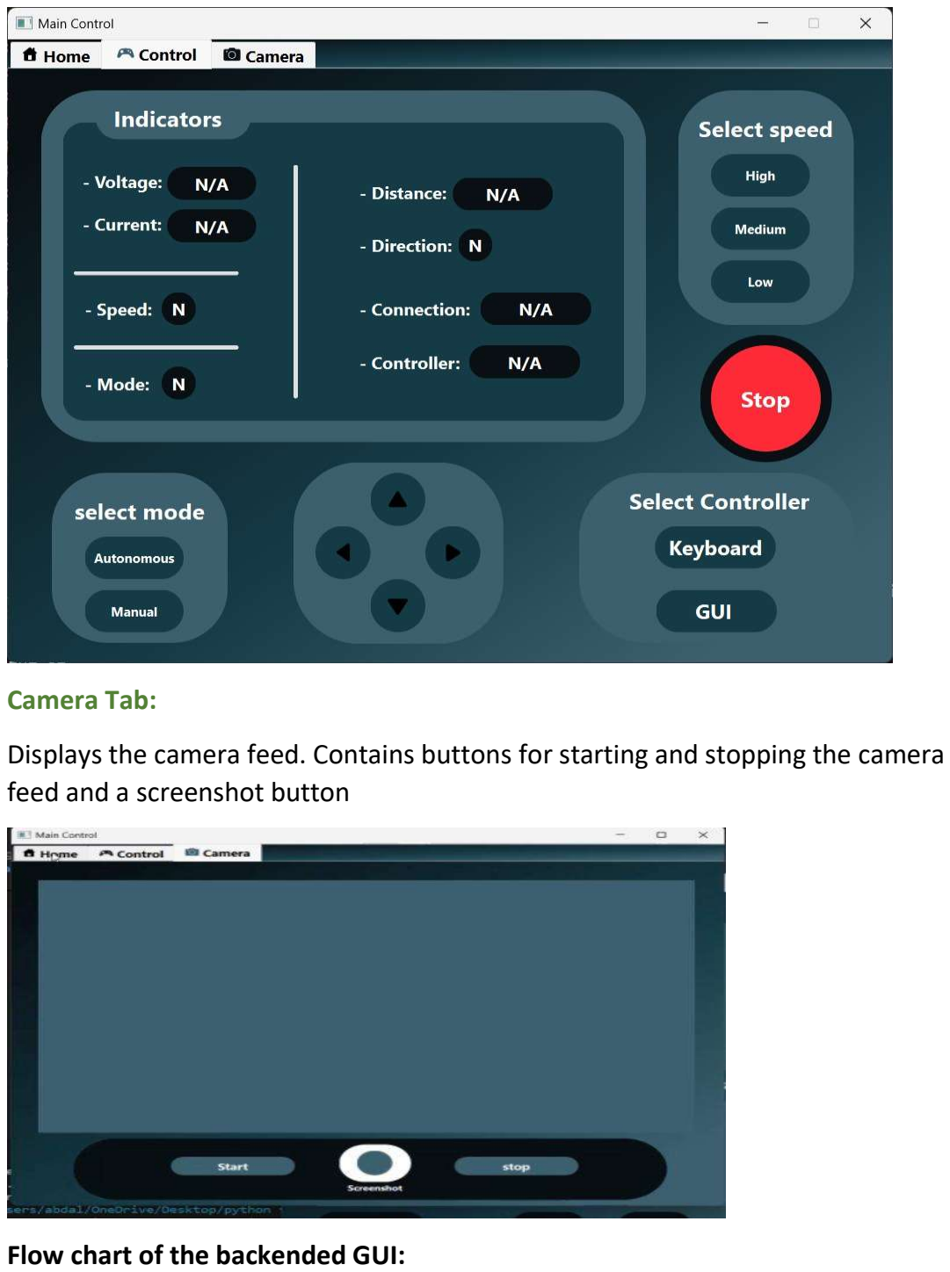
[picture p30: page 25]

Camera Tab:
Displays the camera feed. Contains buttons for starting and stopping the camera feed and a screenshot button

Flow chart of the backended GUI:

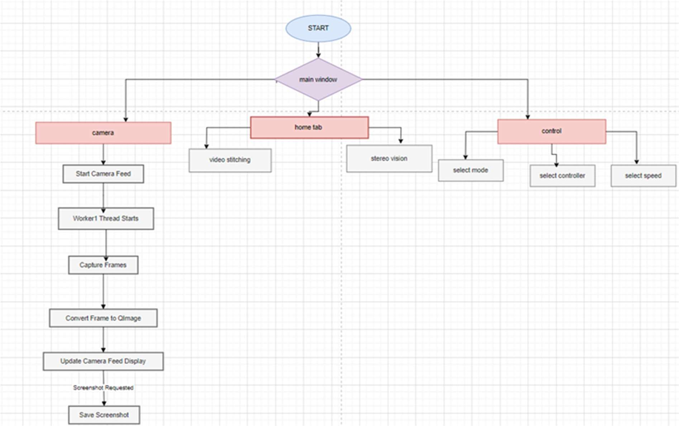
[picture p31: figure]

We use thread for multi-core systems, threads can execute in parallel, which can lead to performance improvements.
The Worker1 class illustrates how to implement a thread safely using QThread.
QThread: This class is a subclass of QThread, which serves as a foundation for running concurrent tasks.
Clean Shutdown: The stop() method safely signals the thread to finish its operations before quitting. This is vital for resource management and preventing memory leaks.

### Sub-window :

1)video stitching window :
- The buttons leftOpen_pushButton and rightOpen_pushButton allow the user to select video files from their system.When a file is selected, the path is stored in the instance variables self.left_path and self.right_path.
- When the user clicks the start_pushButton, the start_videoStitching() method is triggered. This method checks if both video paths are selected and initiates the video stitching process.

- ImageProcessing class runs the stitching algorithm in a separate thread to ensure the GUI remains responsive.
- The progress of the stitching is visualized using a progress bar (progressBar), updated dynamically through signals to avoid blocking the main thread.
Upon completion, the stitched video path is passed to the loop_videos() method, initiating playback.
- After stitching, the videos are displayed in their respective panels (leftVideo_label, rightVideo_label, and stitchedVideo_label).
- VideoLooper class is employed to loop each video in a separate thread, ensuring smooth playback.
- Each frame is processed and converted to a QImage before being displayed in the corresponding QLabel widget. This is done asynchronously, maintaining real-time playback and synchronization with the original video frame rate.
- The stop_pushButton is connected to the stop_videoStitching() method, which stop all active threads.This includes stopping the stitching process (if still running) and all video playback loops, effectively allowing the user to pause the operation at any time.

2)Stereo vision window:
- Buttons: Two buttons, leftOpen_stereo_pushButton and rightOpen_stereo_pushButton, are used for selecting the left and right stereo images.
Implementation: The getFileName_left and getFileName_right methods open a file dialog to allow users to select the images. The paths of the selected images are stored in self.left_path and self.right_path.
- Start Button: The start_stereo_pushButton triggers the stereo vision processing.

Implementation: When the start button is clicked, the start_stereo_vision method creates an instance of the StereoVision_processing class and starts the processing in a separate thread. This class handles tasks like:Loading images and applying Gaussian blur to reduce noise.
- Extracting and matching keypoints using SIFT and BFMatcher, Estimating the Fundamental matrix, decomposing the Essential matrix, and rectifying images.
- Emitting signals to update the GUI with the processed results, such as displaying epipolar lines, disparity maps, and depth maps.
- Dynamic Resizing: The size of the image display area (QLabel) is dynamically resized based on user input for width and height using the update_frame_and_label_size method.
- Mouse Interaction: The get_mouse_position method captures mouse click events on the image and calculates the corresponding pixel coordinates in the original image. It also fetches the Z-value (depth) from the depth map for the clicked point.
Users can select two points on the stereo image. The first point is stored in self.point1, and the second point is stored in self.point2. Once both points are selected, the calculate_distance method calculates the Euclidean distance between the points in pixel units and displays it in the GUI.
- Plotting Results: Epipolar Lines, Disparity, and Depth Maps: After processing, the display_plots method displays the epipolar lines, disparity maps, and depth maps using Matplotlib.
Integration: The StereoVision_processing class emits the Plot_signal signal, which triggers the display_plots method to visualize these results in the GUI.
- Camera Parameters and Baseline Input:
The camera intrinsic matrices (K1 and K2), baseline distance, image width, height, and the number of disparities are set by the user through text fields in the GUI. These parameters are essential for the stereo vision computations and are stored in their respective variables to be used during the processing.

Arduino Connection with GUI:

- The initialize_arduino method is responsible for establishing the serial connection, ensuring that the Arduino is ready for communication.
- A retry mechanism is implemented via check_arduino_connection, which periodically checks if the Arduino is still connected.
- The application provides feedback on the connection status through the update_connection_status method, changing the UI elements to indicate whether the Arduino is connected (green) or disconnected (red).
- The handle_arduino_disconnection method manages scenarios in which the Arduino becomes disconnected. It ensures the worker thread is stopped, and the connection is properly closed, preventing resource leaks.
- An Arduino worker thread (ArduinoWorker) is utilized to handle incoming data from the Arduino without blocking the main GUI thread. This keeps the interface responsive and allows for continuous monitoring without freezing.
- The send_command method abstracts the process of sending commands to the Arduino. It includes error handling to manage situations where command transmission may fail due to connectivity issues.
- The GUI allows users to switch between keyboard and GUI controls using the control_by_GUI method for flexibility in controlling the connected hardware.
- The received data from the Arduino (e.g., voltage, current, distance) is processed and reflected in the GUI in real time. This ensures that users have immediate access to sensor readings.
