Aquaphoton-Training-25/mega-project-team-1/Hardware/MC DESIGN/PCB DESIGN/PCB 2.png

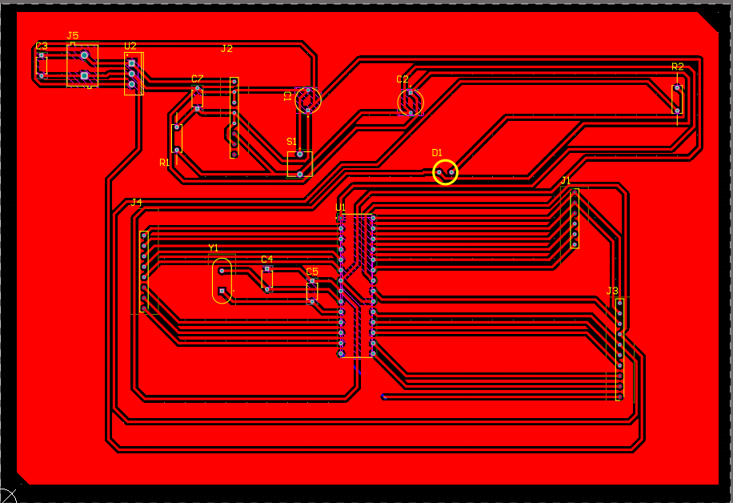
Hardware/MC DESIGN/PCB DESIGN/PCB 2.png
