Aquaphoton-Training-25/mega-project-team-1/Hardware/MC DESIGN/SCHEMATIC/SCH SCREEN SHOT.png

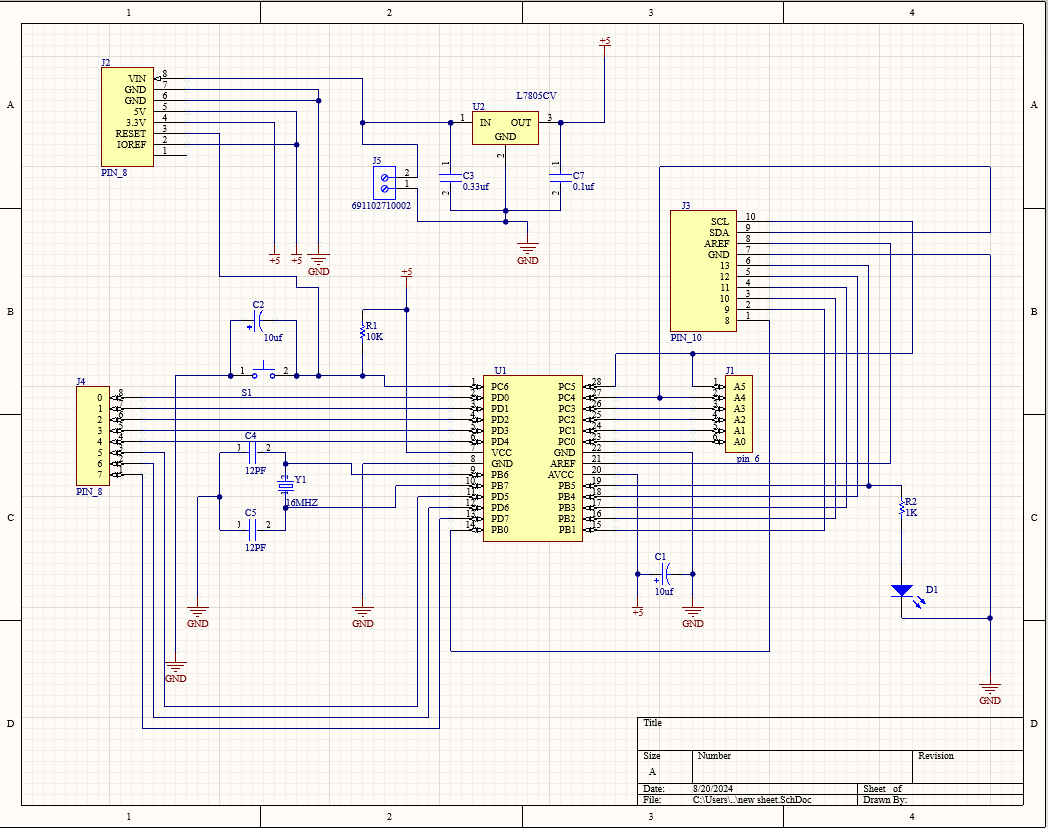
Hardware/MC DESIGN/SCHEMATIC/SCH SCREEN SHOT.png
