Aquaphoton-Training-25/mega-project-team-1/Hardware/SENSORS AND INDICATORS/PCB DESGIN/PCB2.png

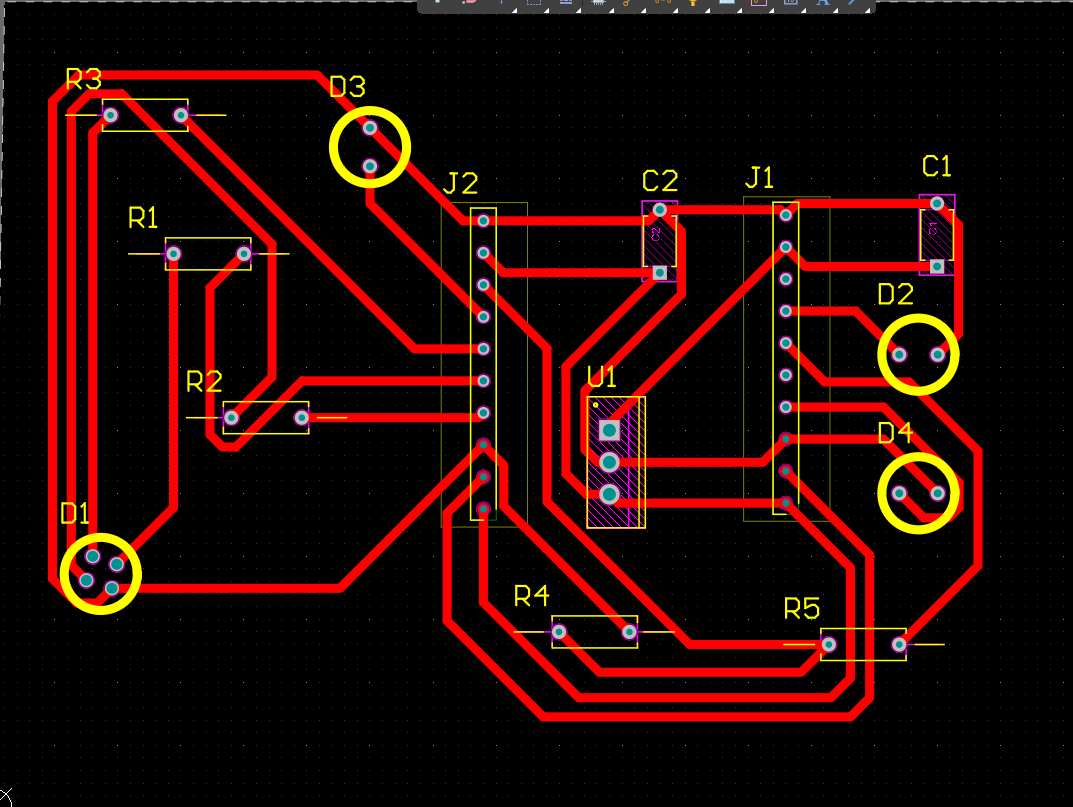
Hardware/SENSORS AND INDICATORS/PCB DESGIN/PCB2.png
