Aquaphoton-Training-25/mega-project-team-1/Hardware/SENSORS AND INDICATORS/SCHEMATIC/SCH2 SCREEN SHOT.png

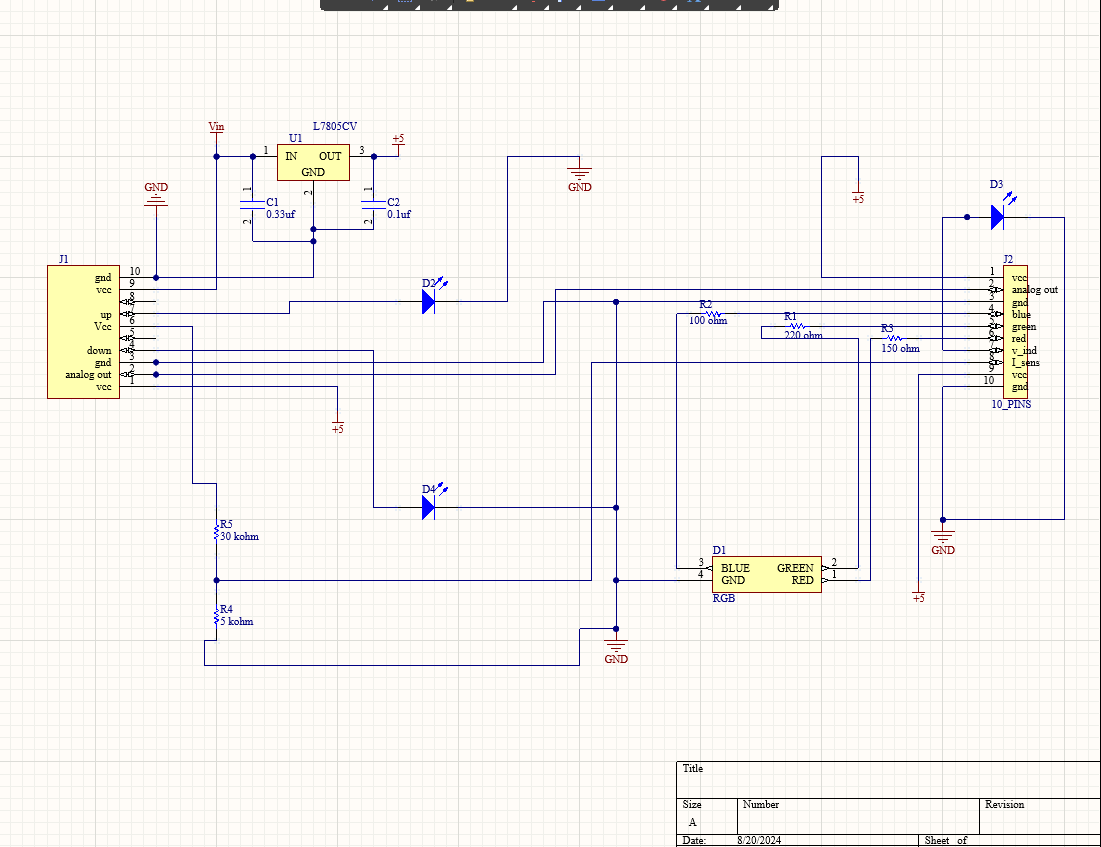
Hardware/SENSORS AND INDICATORS/SCHEMATIC/SCH2 SCREEN SHOT.png
