Aquaphoton-Training-25/mega-project-team-1/Hardware/MC DESIGN/PRINTED OUTPUT/FINAL PCB PRINT.pdf

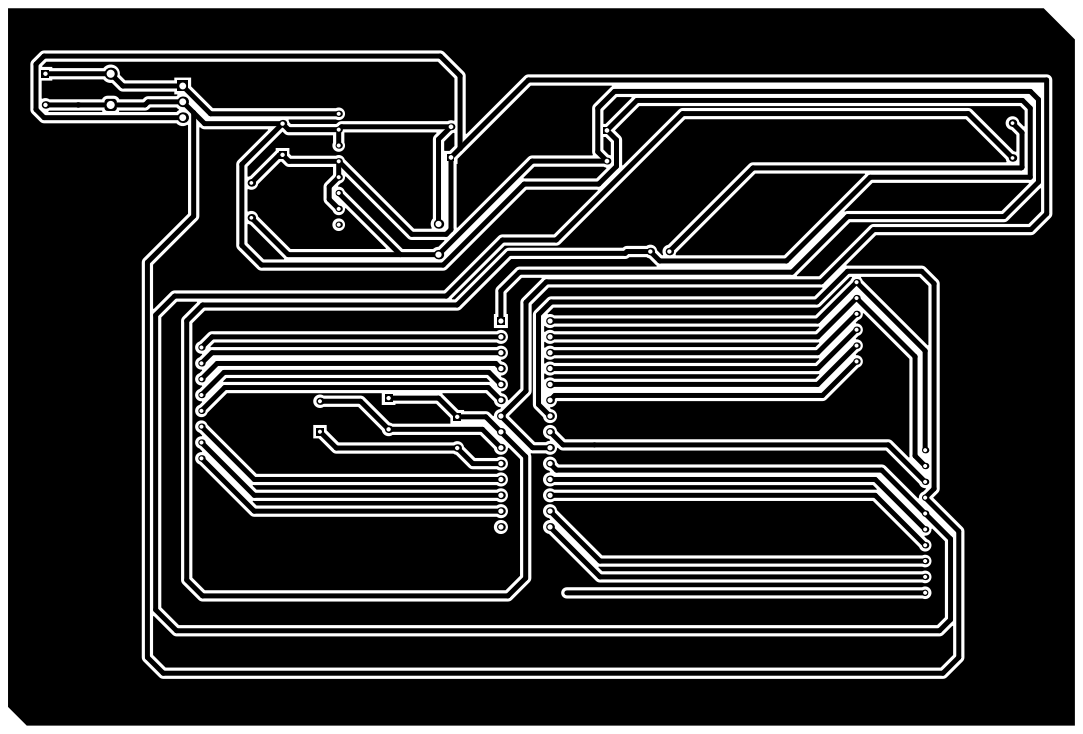
[picture p36: page 1]
