Aquaphoton-Training-25/mega-project-team-1/Hardware/MC DESIGN/PRINTED OUTPUT/PCB FINAL STICKER.pdf

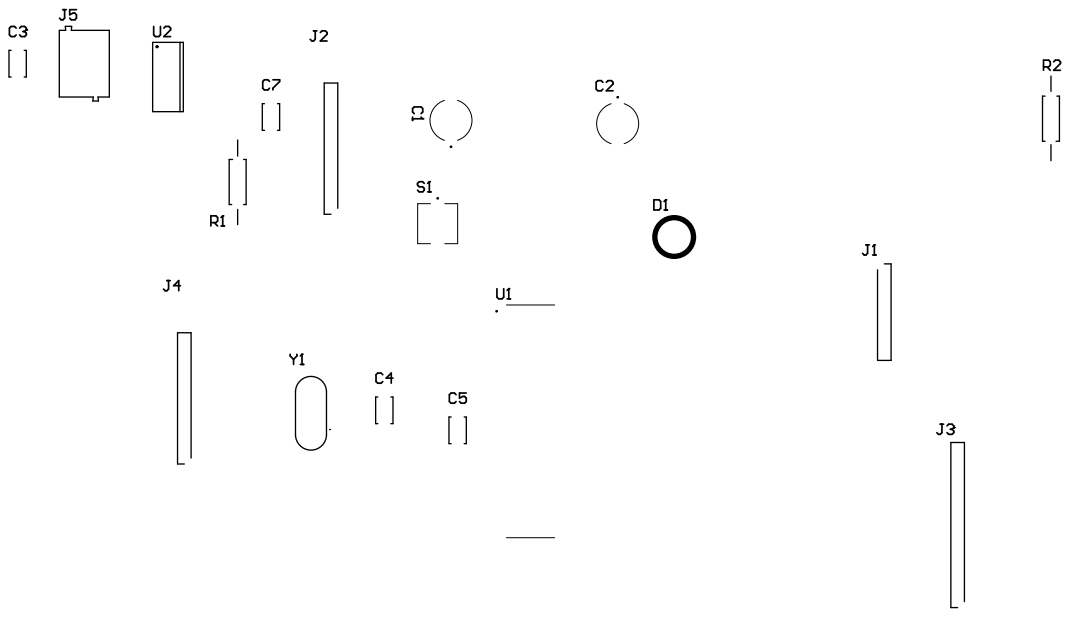
[picture p37: page 1]
