Aquaphoton-Training-25/mega-project-team-1/Hardware/SENSORS AND INDICATORS/PRINTED OUTPUT/pcb1.pdf

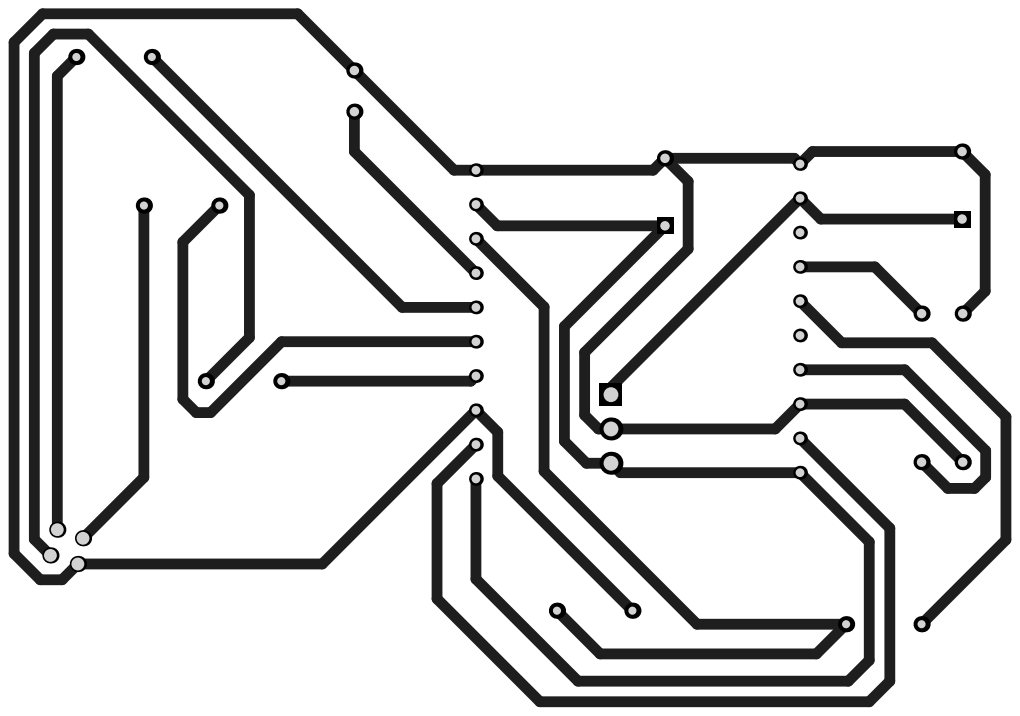
[picture p38: page 1]
