Aquaphoton-Training-25/mega-project-team-1/(list of files, drawings)

Other design files:
Hardware/MC DESIGN/EXTERNAL LIBRARIES/22-23-2101.SchLib
Hardware/MC DESIGN/EXTERNAL LIBRARIES/ATMEGA328-PU.SchLib
Hardware/MC DESIGN/EXTERNAL LIBRARIES/CAPPRD500W50D630H1120.PcbLib
Hardware/MC DESIGN/EXTERNAL LIBRARIES/DIP787W46P254L3467H508Q28.PcbLib
Hardware/MC DESIGN/EXTERNAL LIBRARIES/EEUFC2A100B.SchLib
Hardware/MC DESIGN/EXTERNAL LIBRARIES/HDRV8W69P0X254_1X8_2032X251X1641P.PcbLib
Hardware/MC DESIGN/EXTERNAL LIBRARIES/SHDR10W87P0X254_1X10_2525X635X1105P.PcbLib
Hardware/MC DESIGN/EXTERNAL LIBRARIES/XT9S20ANA16M.PcbLib
Hardware/MC DESIGN/PCB DESIGN/PCB1 final.PcbDoc
Hardware/MC DESIGN/PCB_MC.PrjPcb
Hardware/MC DESIGN/SCHEMATIC/new sheet.SchDoc
Hardware/SENSORS AND INDICATORS/PCB DESGIN/PCB3.PcbDoc
Hardware/SENSORS AND INDICATORS/SCHEMATIC/Sheet1.SchDoc
Hardware/SENSORS AND INDICATORS/sensors and indicators.PrjPcb
